m2moiz/Autonomous-Line-Follower/CAD/front view.PNG

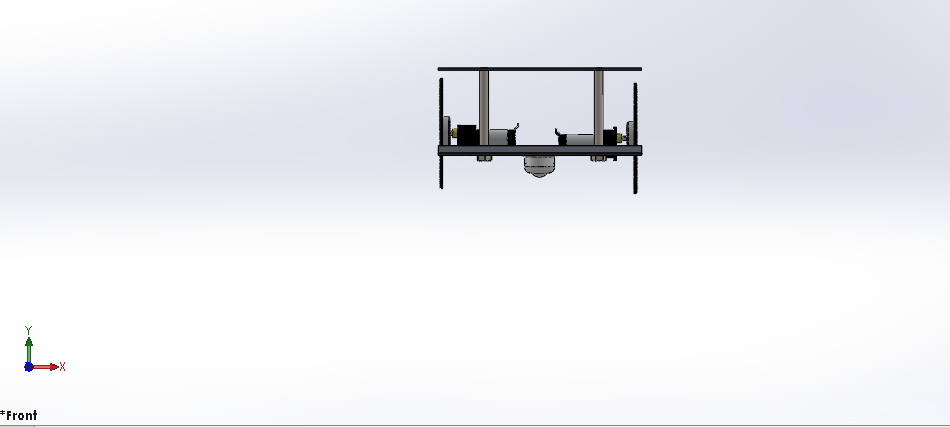
CAD/front view.PNG
