m2moiz/Autonomous-Line-Follower/CAD/isometric view.PNG

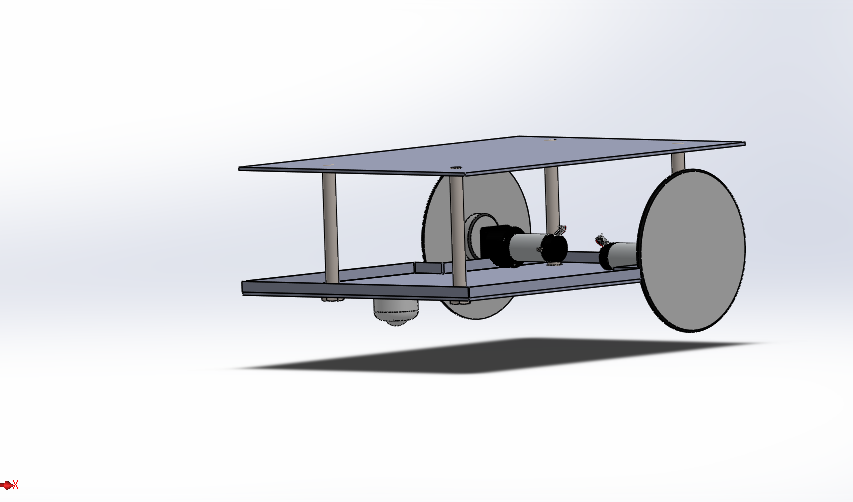
CAD/isometric view.PNG
