m2moiz/Autonomous-Line-Follower/Motherboard/Motherboard Schematic.PDF

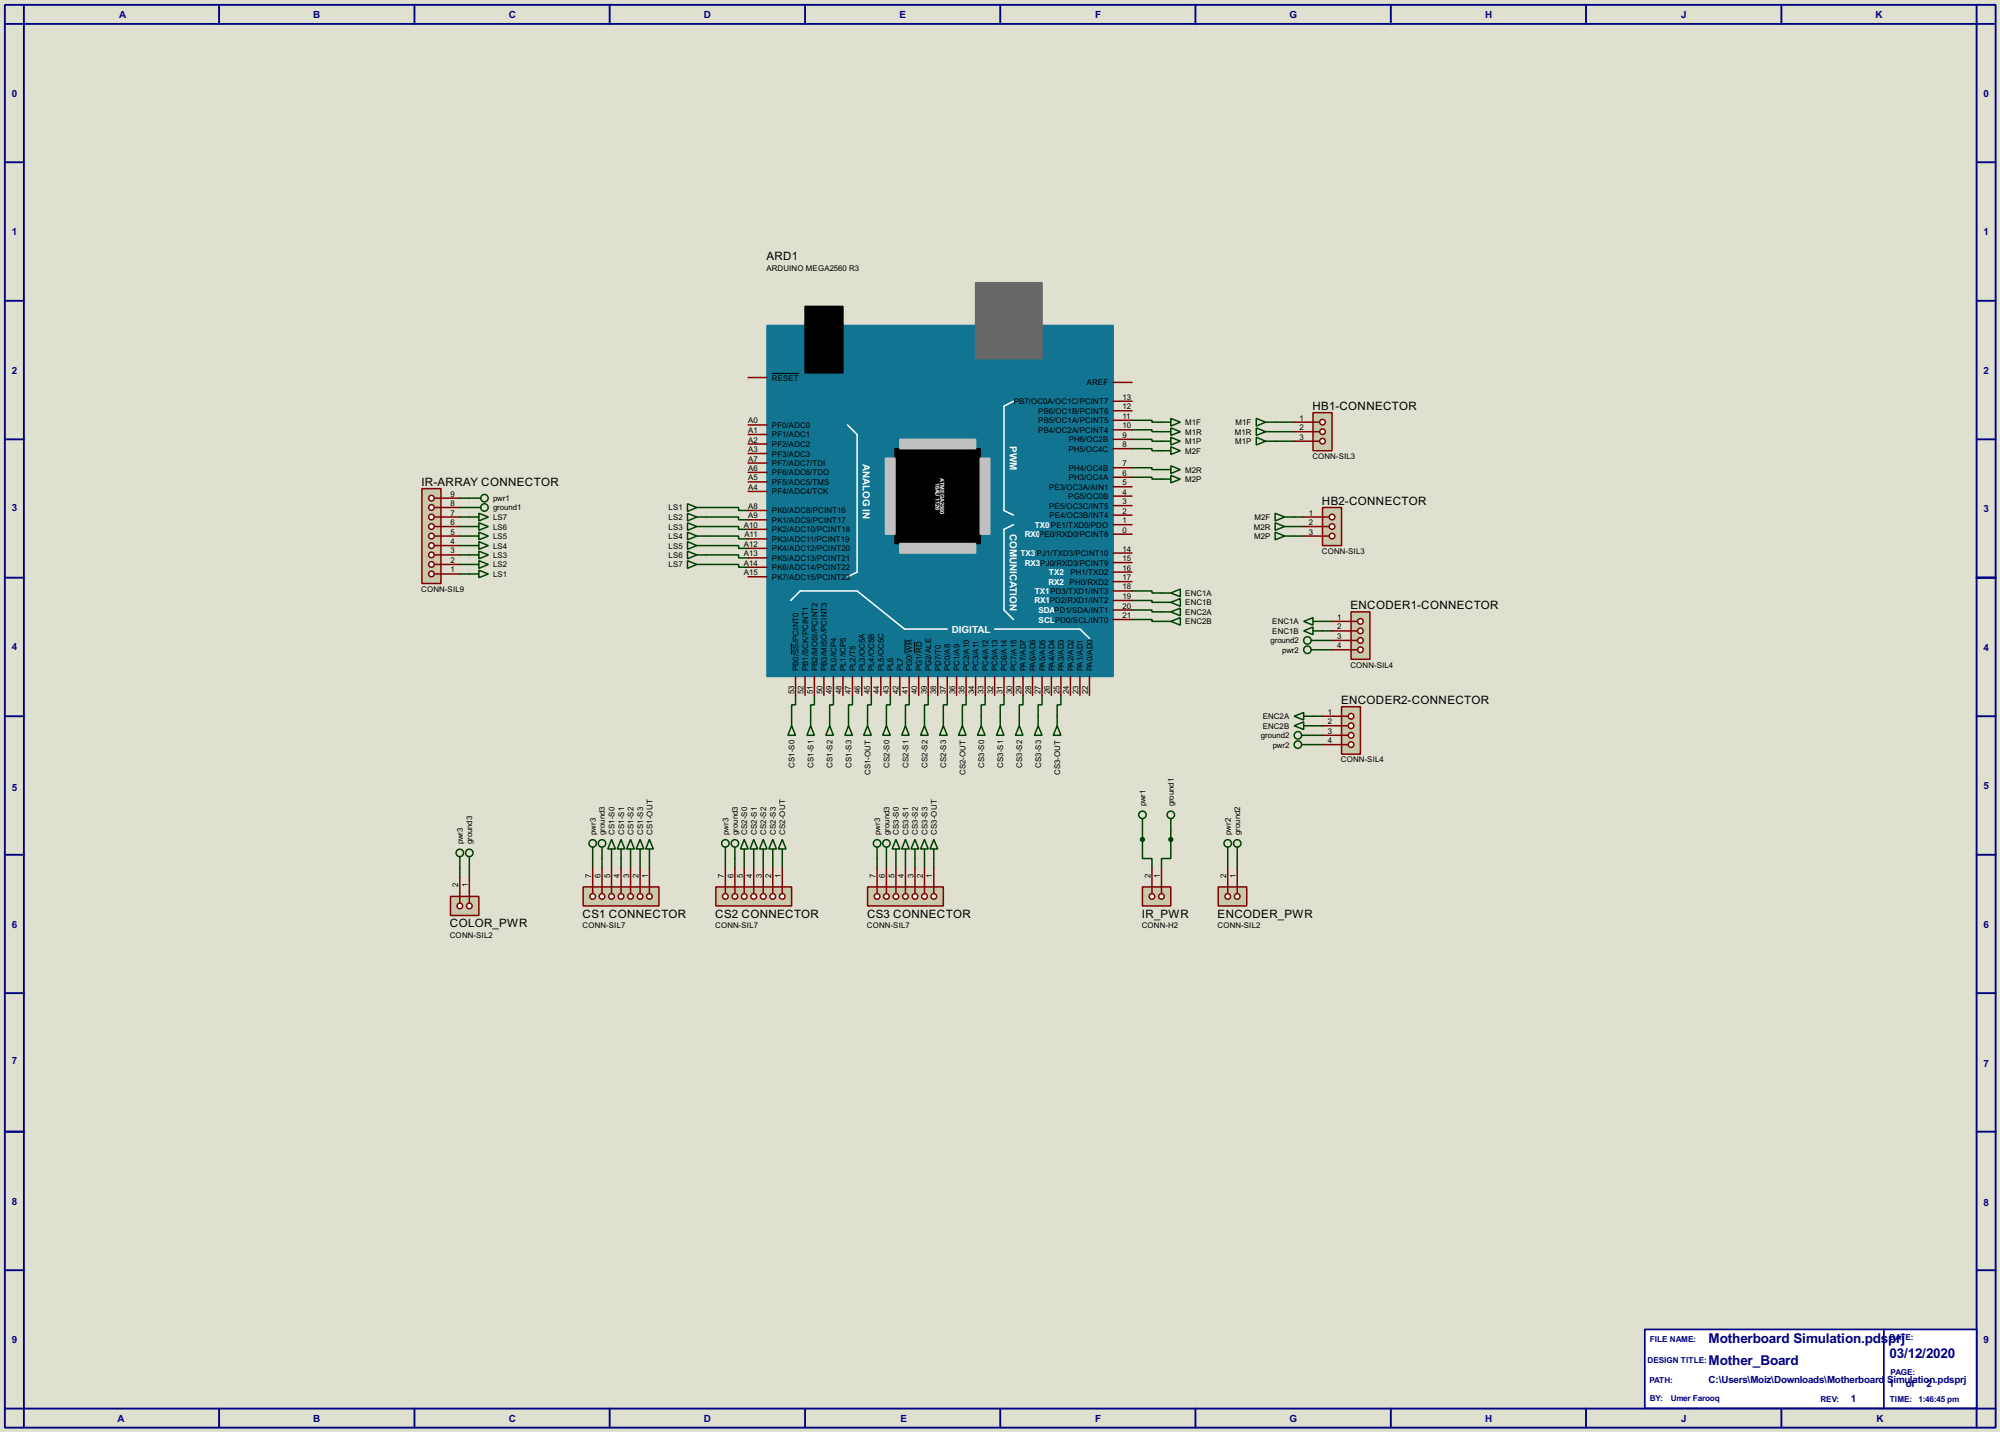
[picture p23: page 1]

PAGE: Motherboard Simulation.pdsprj
