m2moiz/Autonomous-Line-Follower/Power Supply/Power Supply Schematic.PDF

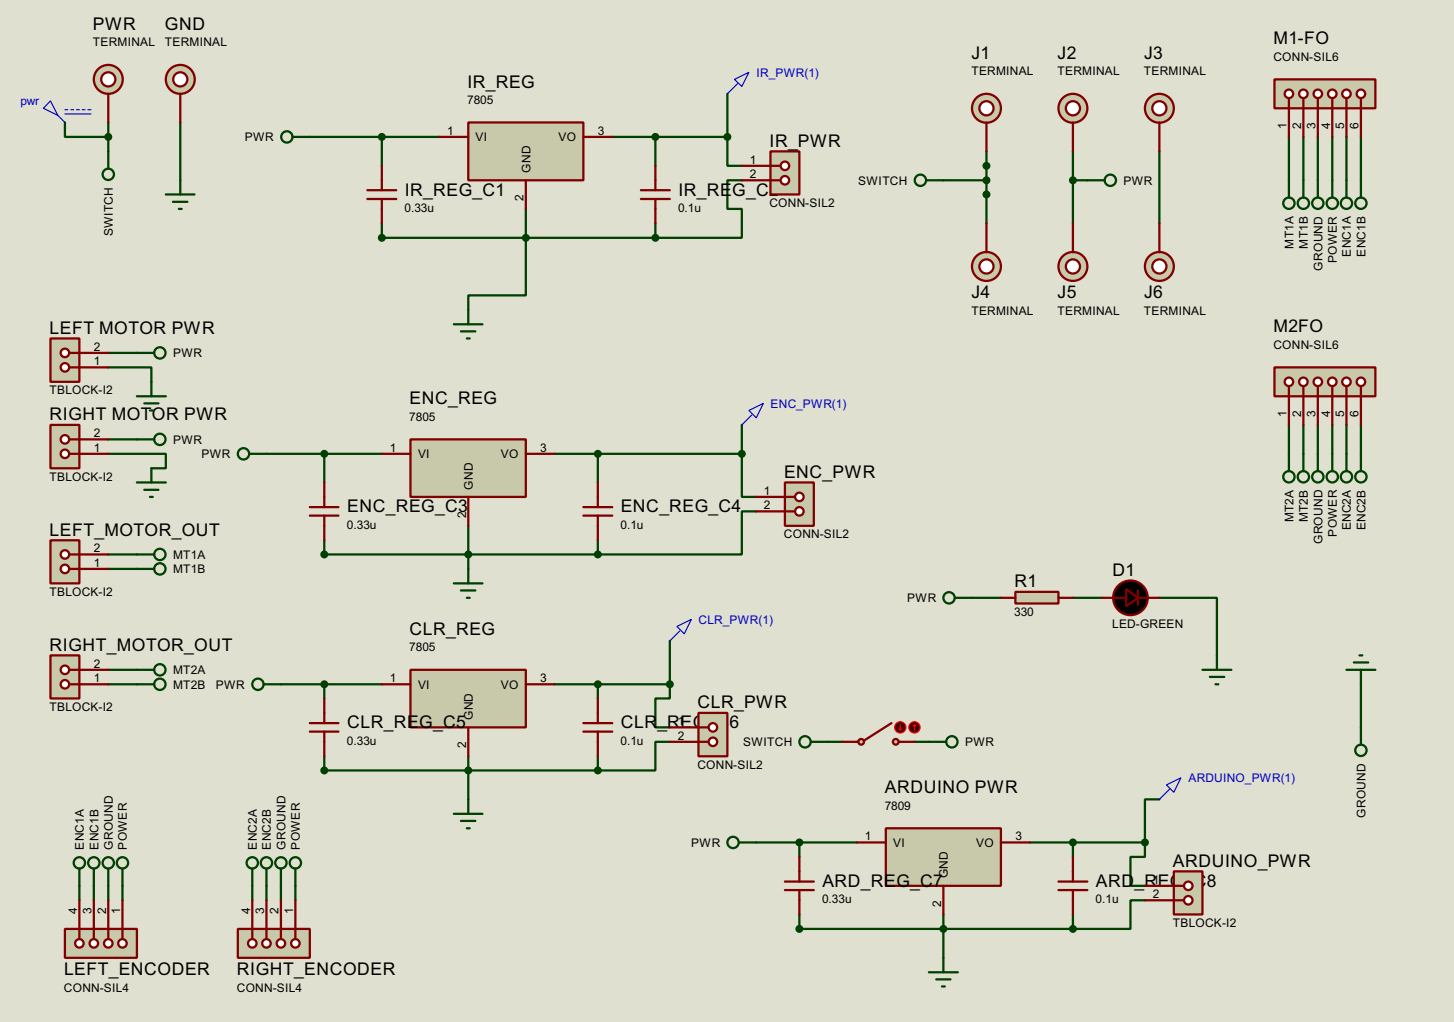
[picture p24: page 1]
