m2moiz/Autonomous-Line-Follower/Motor Driver/H-Bridge Schematic.PDF

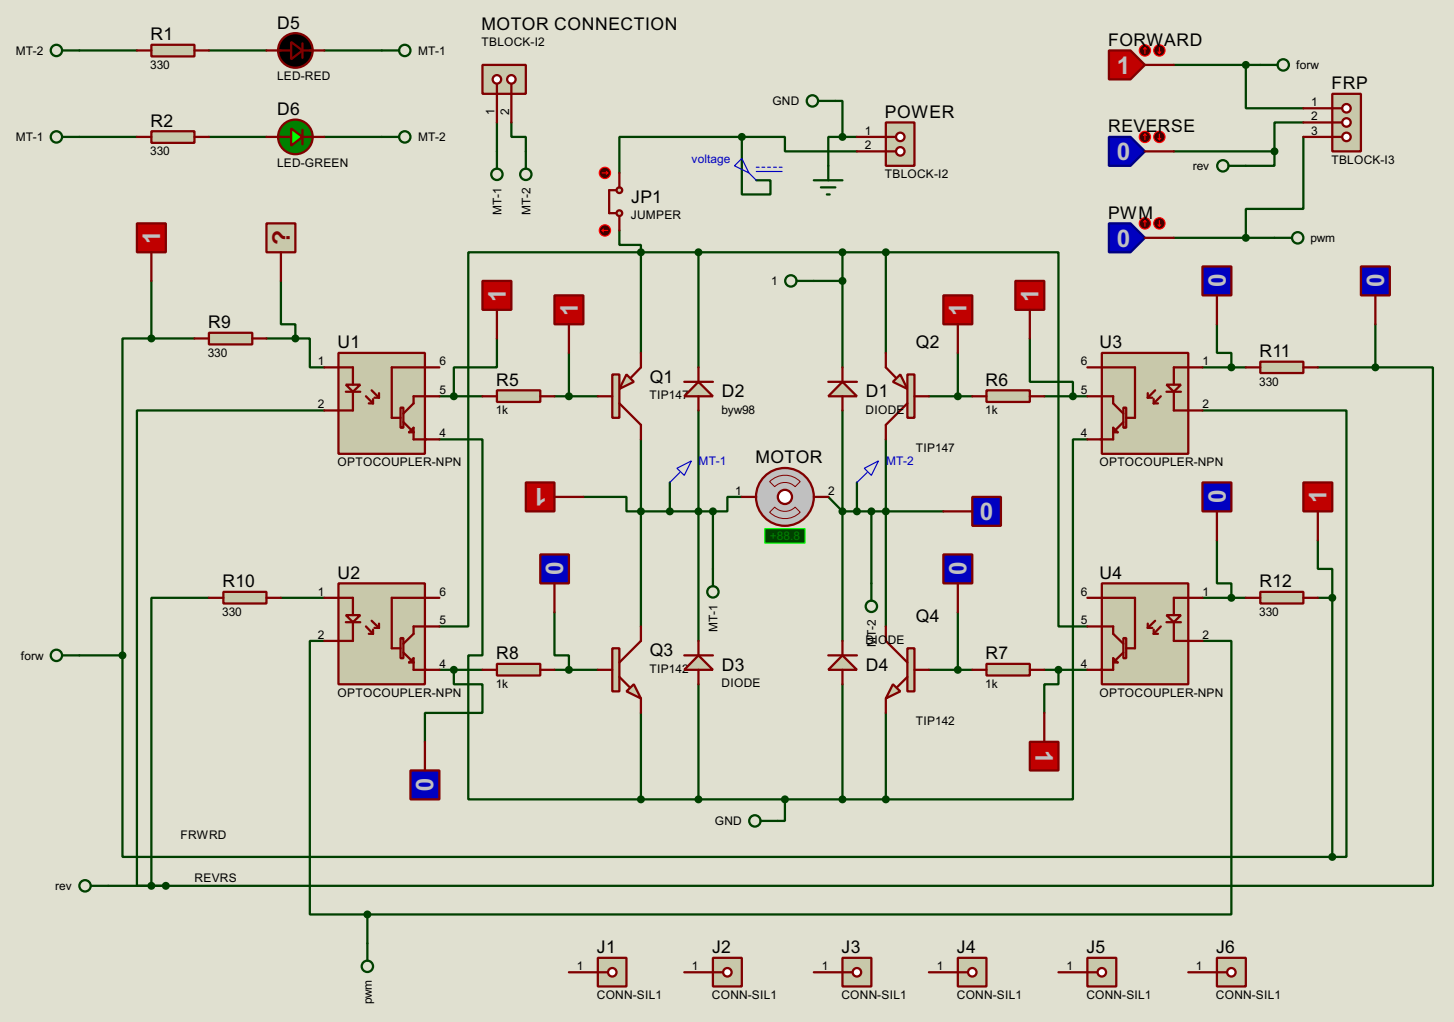
[picture p25: page 1]
