m2moiz/Autonomous-Line-Follower/Motherboard/Motherboard PCB Layout.PDF

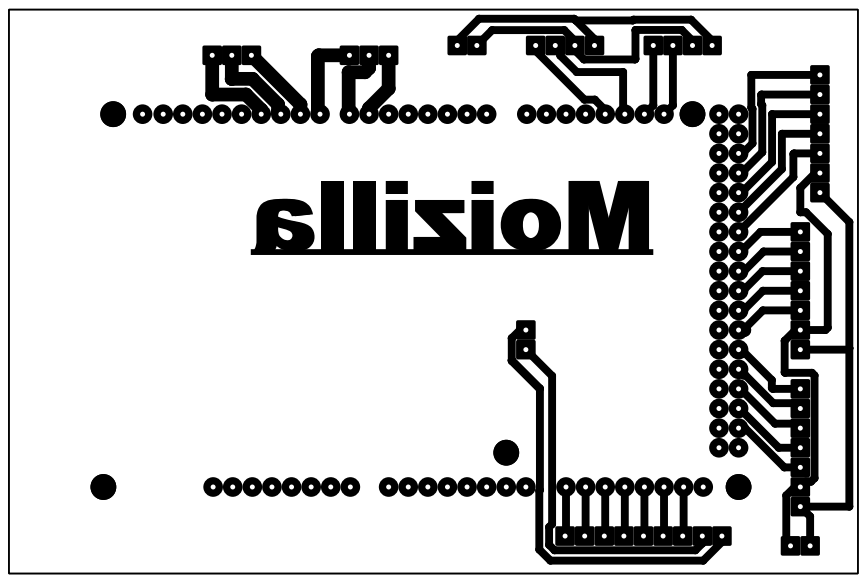
[picture p26: page 1]
