m2moiz/Autonomous-Line-Follower/Power Supply/Power Supply PCB Layout.PDF

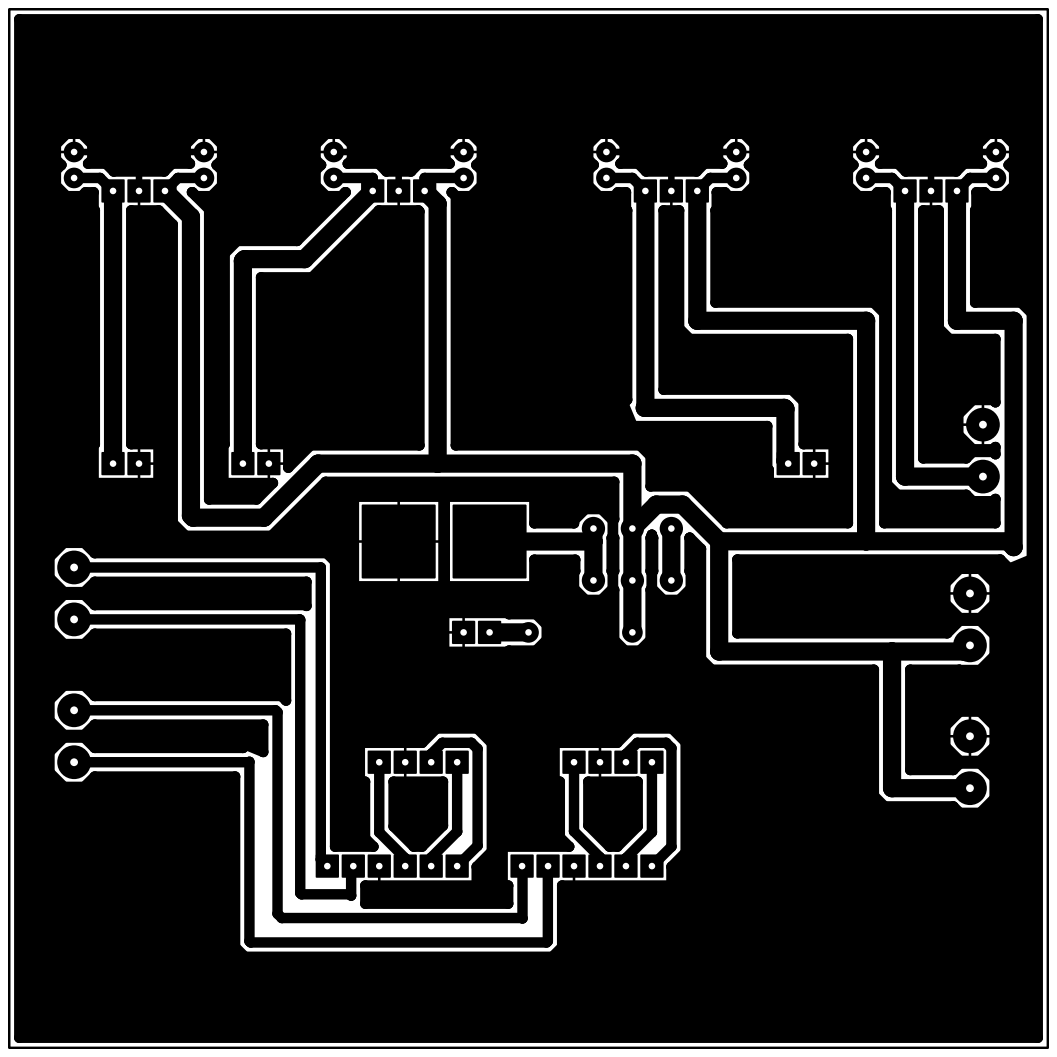
[picture p27: page 1]
