m2moiz/Autonomous-Line-Follower/Motor Driver/H-Bridge PCB Layout.PDF

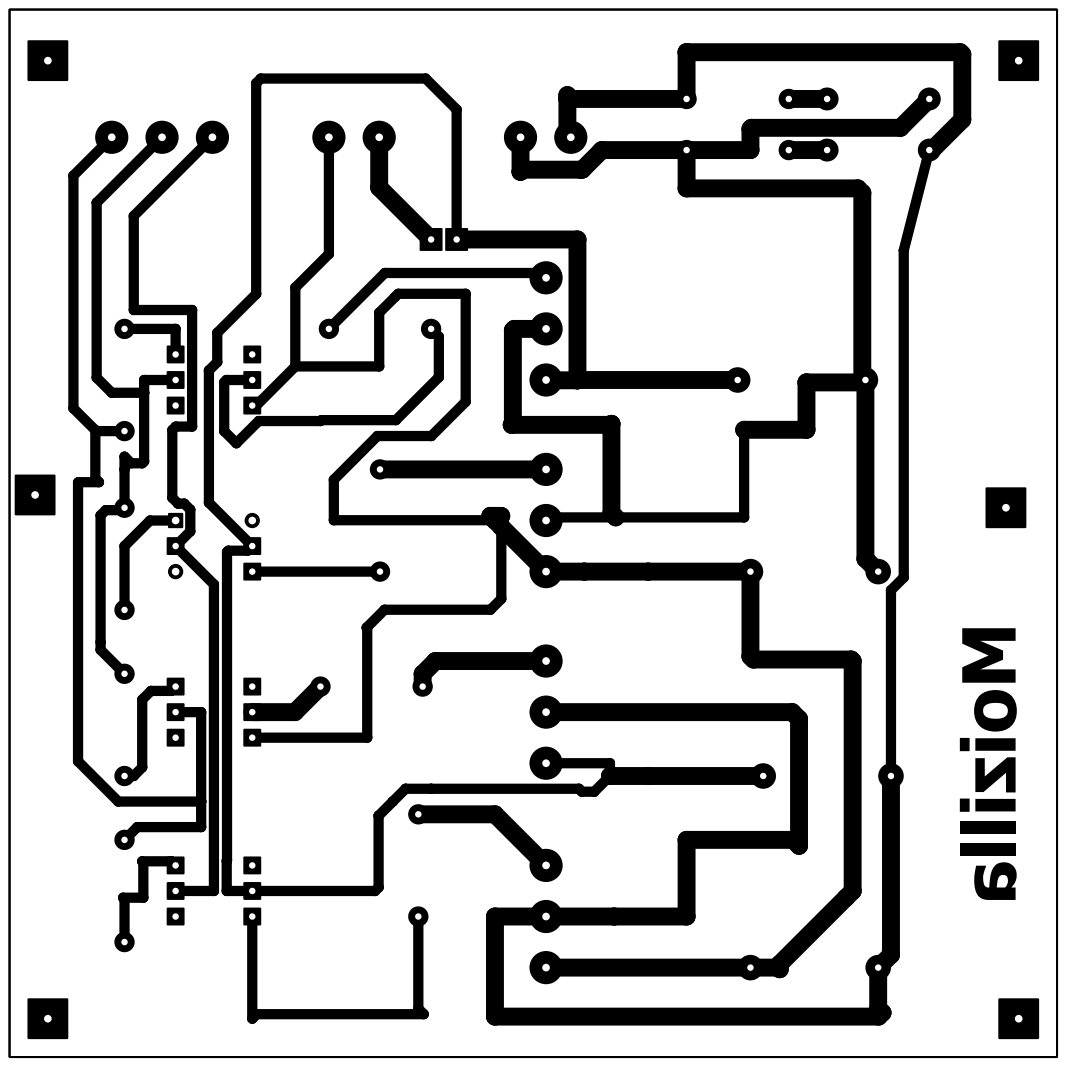
[picture p28: page 1]
