m2moiz/Autonomous-Line-Follower/(list of files, drawings)

Other design files:
Motherboard/Motherboard Simulation.pdsprj
Motor Driver/H-Bridge Simulation.pdsprj
Power Supply/Power Supply Simulation.pdsprj
