m2moiz/Autonomous-Line-Follower/Arduino Code/p_displayEncoderReadings.ino

void displayEncoderReadings()
{
  long newLeft, newRight;
  newLeft = motorLeft.read();
  newRight = motorRight.read();
    if (newLeft != positionLeft || newRight != positionRight) 
    {
      Serial.print("Left = ");
      Serial.print(newLeft);
      Serial.print(", Right = ");
      Serial.print(newRight);
      Serial.println();
      positionLeft = newLeft;
      positionRight = newRight;
    }
}
