m2moiz/Autonomous-Line-Follower/Arduino Code/r_leftPriority.ino

/*void leftPriority(int case_junc)
{

  switch (case_junc) 
  {
    case 1:    // your hand is on the sensor
     movement_at_junction[junction] += 1;
     turnRight();
      break;
    case 2:    // your hand is close to the sensor
     movement_at_junction[junction] += 1;
     turnRight();
      break;
    case 3:    // your hand is a few inches from the sensor
      movement_at_junction[junction] += 2;
      forward();
      break;
    case 4:    // your hand is nowhere near the sensor
      movement_at_junction[junction] += 1;
      turnRight();
      break;
}
}
*/
