m2moiz/Autonomous-Line-Follower/Arduino Code/t_forwardStep.ino

/*void forwardStep()
{
   long currentLeft, currentRight;
  currentLeft = motorLeft.read();
  currentRight = motorRight.read();
    if (newLeft != positionLeft || newRight != positionRight) 
    {
      positionLeft = newLeft;
      positionRight = newRight;
    }
    while()
}
}
*/
