m2moiz/Autonomous-Line-Follower/(commit log)

2020-12-03 Create motor driver.md
2020-12-03 Create power supply.md
